MarcelKleiner/Puch/Zuendung/Bilder/IMG_3580.jpg

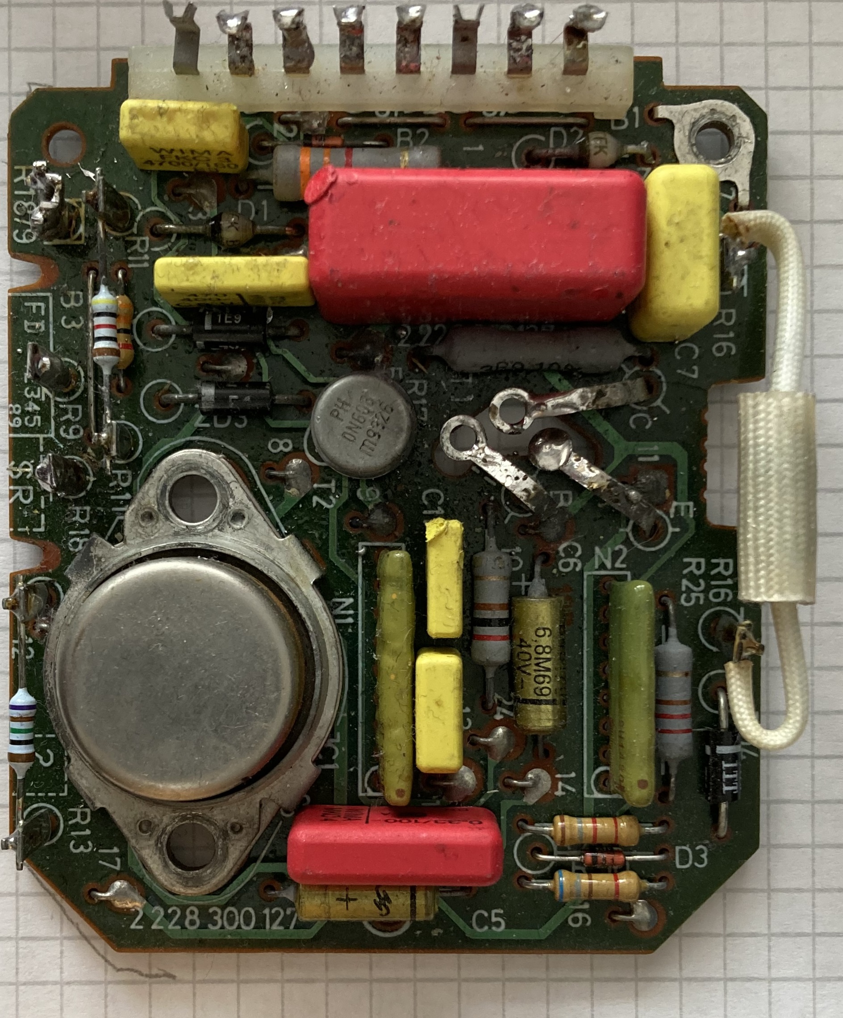
Zuendung/Bilder/IMG_3580.jpg
