MarcelKleiner/Puch/Zuendung/Bilder/PCB.docx

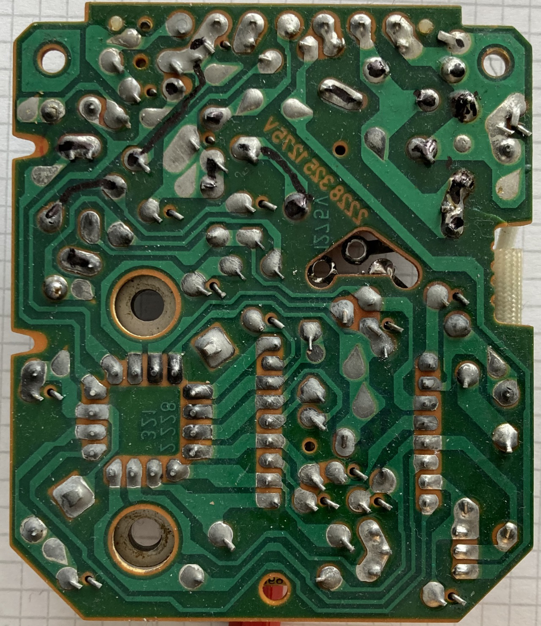
[picture p2: figure]
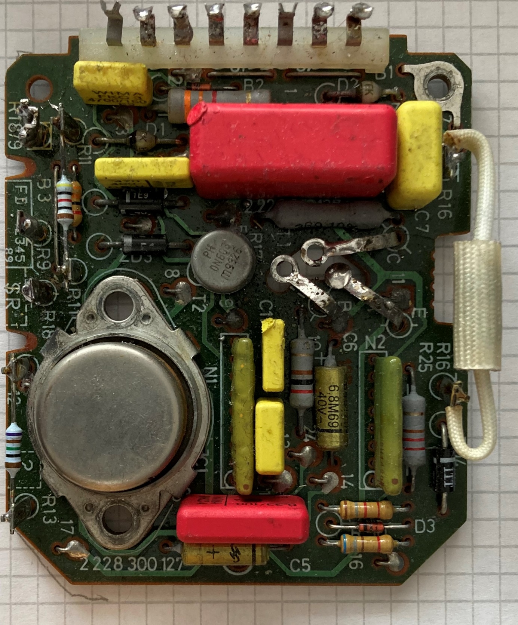
[picture p3: figure]
