MarcelKleiner/Puch/Zuendung/Software/IgnitionConfiguration/IgnitionConfiguration/Image2.png

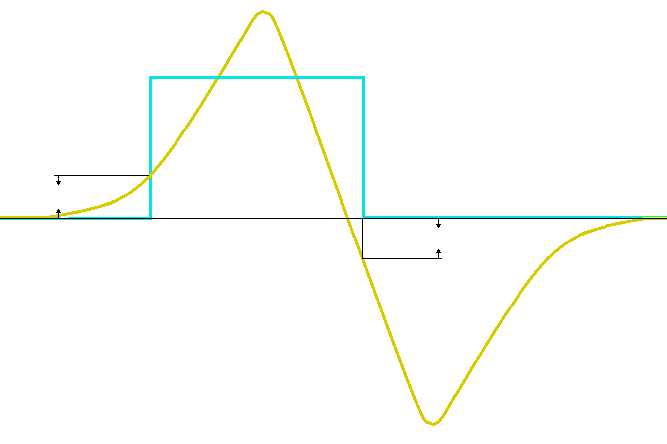
Zuendung/Software/IgnitionConfiguration/IgnitionConfiguration/Image2.png
