MarcelKleiner/Puch/Zuendung/Hardware/Zuendung/Schema.pdf

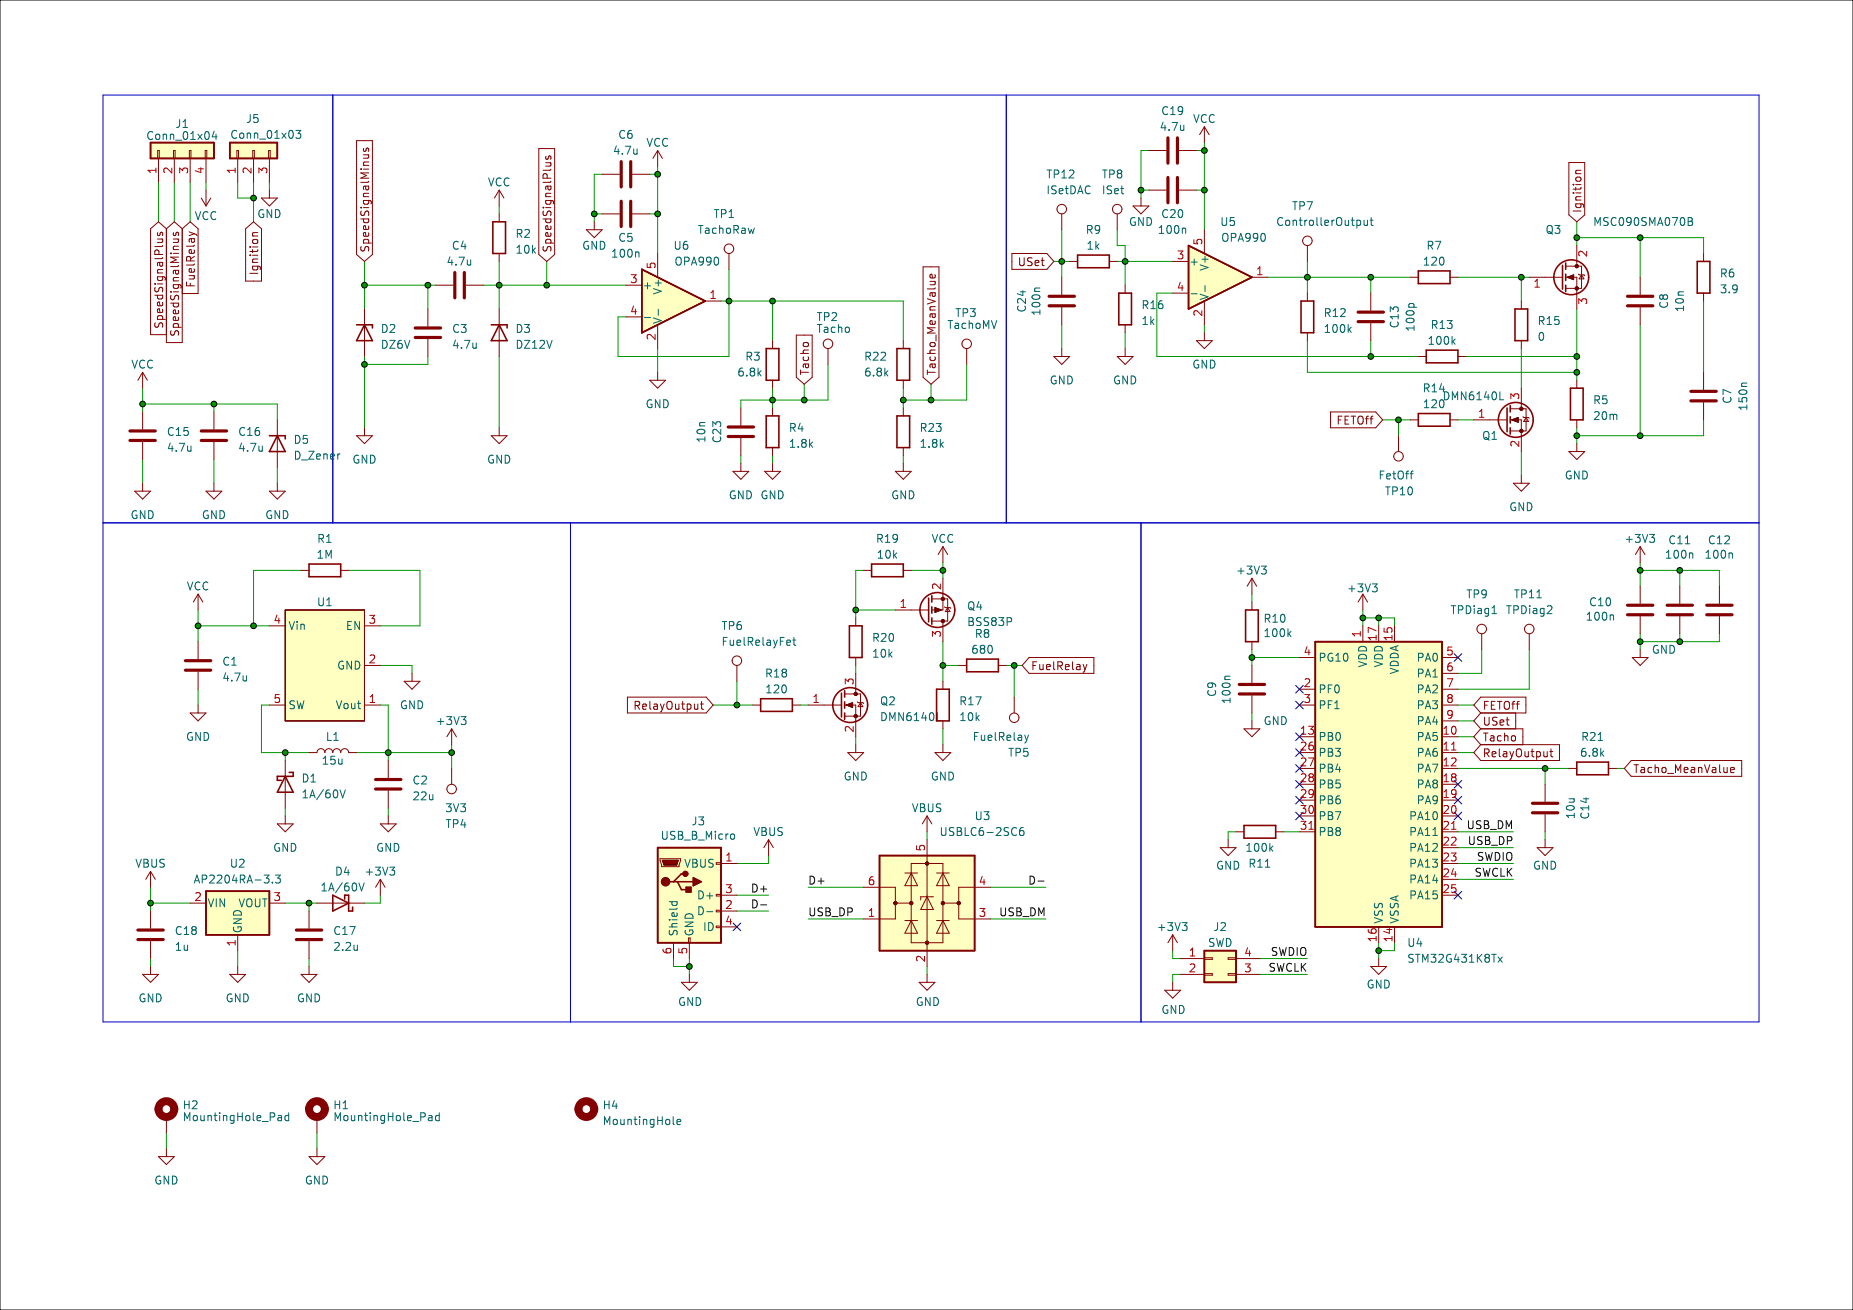
[picture p5: page 1]
