MarcelKleiner/Puch/Zuendung/Hardware/Zuendung/Zuendung.kicad_pcb

## KiCad design Zuendung/Hardware/Zuendung/Zuendung.kicad_pcb (2024-05-12)

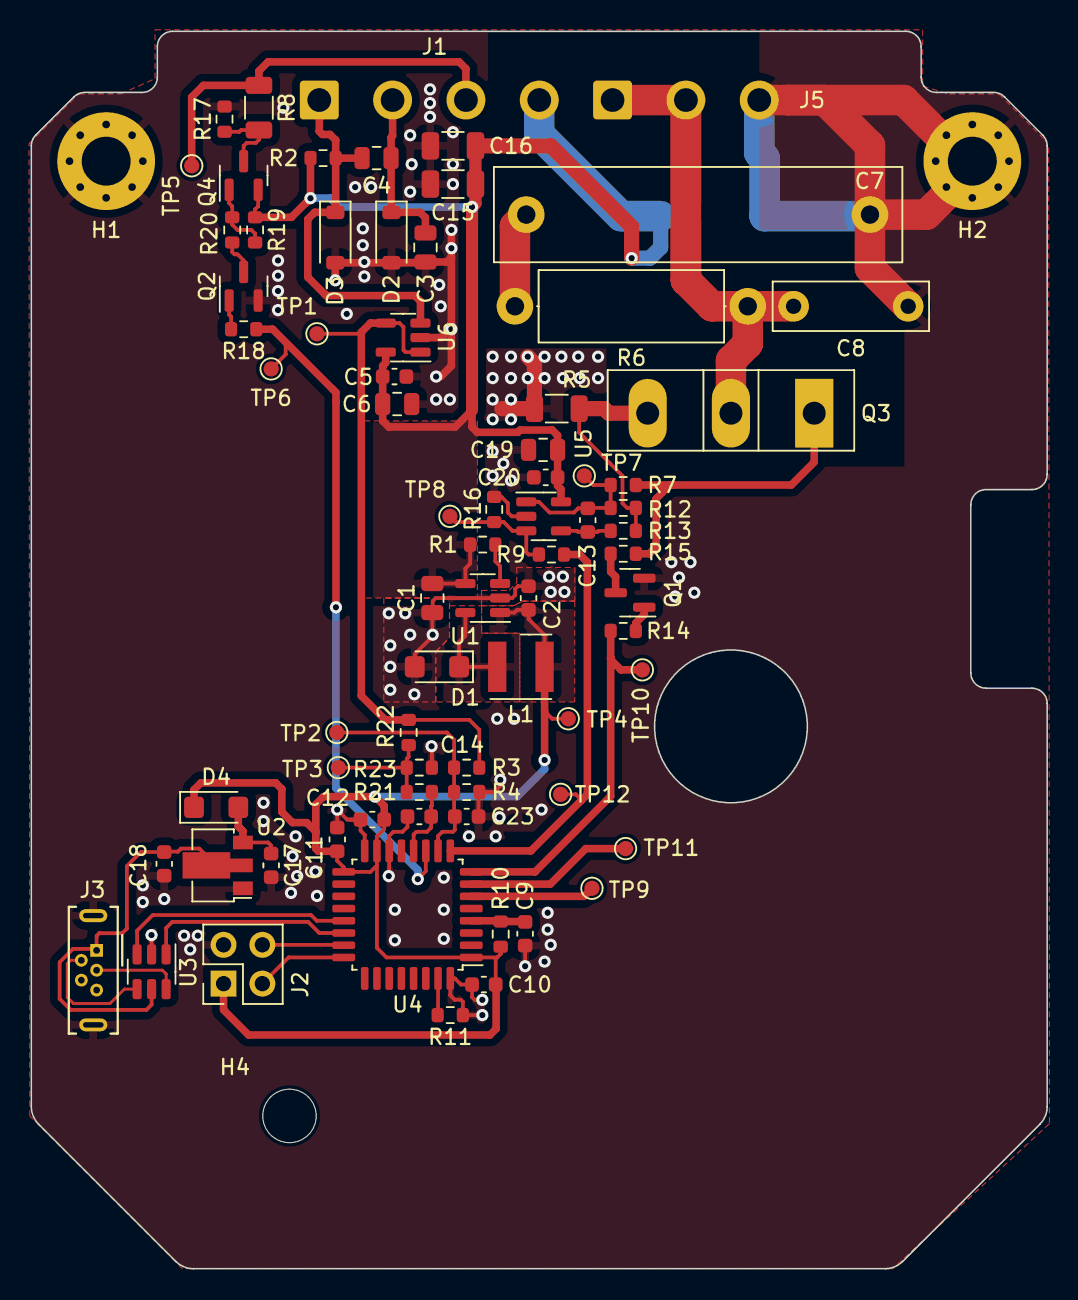
[picture p6: board Zuendung.kicad_pcb from above]

Board: 2 copper layers, 66.5 x 81.0 mm, 79 parts (1 on the bottom side), 40 nets.

Parts:
C1, C3, C4, C6, C19: 4.7u; C_0805_2012Metric
C2: 22u; C_0603_1608Metric
C5, C9, C10, C11, C12, C20: 100n; C_0603_1608Metric
C7: 150n; C_Rect_L26.5mm_W6.0mm_P22.50mm_MKS4
C8: 10n; C_Rect_L10.0mm_W3.0mm_P7.50mm_MKS4
C13: 100p; C_0603_1608Metric
C14: 10u; C_0603_1608Metric
C15, C16: 4.7u; C_1206_3216Metric
C17: 2.2u; C_0603_1608Metric
C18: 1u; C_0603_1608Metric
C23: 10n; C_0603_1608Metric
D1, D4: 1A/60V; D_SMF
D2: DZ6V; D_SOD-123
D3: DZ12V; D_SOD-123
D5: D_Zener; D_SMC
H1, H2: MountingHole_Pad; MountingHole_3.2mm_M3_Pad_Via
H4: MountingHole; MountingHole_3.5mm
J1: Conn_01x04; SolderWire-0.75sqmm_1x04_P4.8mm_D1.25mm_OD2.3mm
J2: SWD; PinHeader_2x02_P2.54mm_Vertical
J3: USB_B_Micro; USB_Micro-B_Wuerth_614105150721_Vertical
J5: Conn_01x03; SolderWire-0.75sqmm_1x03_P4.8mm_D1.25mm_OD2.3mm
L1: 15u; L_Wurth_WE-LQSH-4020
Q1, Q2: DMN6140L; SOT-23
Q3: MSC090SMA070B; TO-247-3_Vertical
Q4: BSS83P; SOT-23
R1: 1M; R_0603_1608Metric
R2, R17, R19, R20: 10k; R_0603_1608Metric
R3, R21, R22: 6.8k; R_0603_1608Metric
R4, R23: 1.8k; R_0603_1608Metric
R5: 20m; R_1206_3216Metric
R6: 3.9; R_Axial_DIN0414_L11.9mm_D4.5mm_P15.24mm_Horizontal
R7: 750; R_0603_1608Metric
R8: 680; R_1206_3216Metric
R9: 2.4k; R_0603_1608Metric
R10, R11, R12, R13: 100k; R_0603_1608Metric
R14, R18: 120; R_0603_1608Metric
R15: 0; R_0603_1608Metric
R16: 1; R_0603_1608Metric
TP1: TachoRaw; TestPoint_Pad_D1.0mm
TP2: Tacho; TestPoint_Pad_D1.0mm
TP3: TachoMV; TestPoint_Pad_D1.0mm
TP4: 3V3; TestPoint_Pad_D1.0mm
TP5: FuelRelay; TestPoint_Pad_D1.0mm
TP6: FuelRelayFet; TestPoint_Pad_D1.0mm
TP7: ControllerOutput; TestPoint_Pad_D1.0mm
TP8: ISet; TestPoint_Pad_D1.0mm
TP9: TPDiag1; TestPoint_Pad_D1.0mm
TP10: FetOff; TestPoint_Pad_D1.0mm
TP11: TPDiag2; TestPoint_Pad_D1.0mm
TP12: ISetDAC; TestPoint_Pad_D1.0mm
U1: SOT-23-5
U2: AP2204RA-3.3; SOT-89-3
U3: USBLC6-2SC6; SOT-23-6
U4: STM32G431K8Tx; LQFP-32_7x7mm_P0.8mm
U5, U6: OPA990; SOT-23-5

Connections:
+3V3: C2.1, C10.2, C11.2, C12.2, D4.1 (K), J2.1, L1.2, R10.1, TP4.1, U1.1 (Vout), U4.1 (VDD), U4.15 (VDDA), U4.17 (VDD)
/D+: J3.3 (D+), U3.6 (I/O1)
/D-: J3.2 (D-), U3.4 (I/O2)
/SWCLK: J2.3, U4.24 (PA14)
/SWDIO: J2.4, U4.23 (PA13)
/USB_DM: U3.3 (I/O2), U4.21 (PA11)
/USB_DP: U3.1 (I/O1), U4.22 (PA12)
FETOff: R14.1, TP10.1, U4.8 (PA3)
FuelRelay: J1.3, R8.1, TP5.1
GND: C1.2, C2.2, C3.2, C5.2, C6.2, C7.1, C8.1, C9.1, C10.1, C11.1, C12.1, C14.1, C15.2, C16.2, C17.2, C18.2, C19.2, C20.2, C23.1, D1.2 (A), D2.2 (A), D3.2 (A), D5.2 (A), H1.1, H2.1, J2.2, J3.5 (GND), J3.6 (Shield), J5.3, Q1.2 (S), Q2.2 (S), R4.2, R5.2, R11.1, R16.2, R17.2, R23.2, U1.2 (GND), U2.1 (GND), U3.2 (GND), U4.14 (VSSA), U4.16 (VSS), U4.32 (VSS), U5.2 (V-), U6.2 (V-)
Ignition: C8.2, J5.1, J5.2, Q3.2 (D), R6.1
unnamed: C7.2, R6.2
unnamed: C13.1, R7.1, R12.2, TP7.1, U5.1
unnamed: D1.1 (K), L1.1, U1.5 (SW)
unnamed: C17.1, D4.2 (A), U2.3 (VOUT)
unnamed: Q1.3 (D), R15.1
unnamed: Q1.1 (G), R14.2
unnamed: Q2.3 (D), R20.2
unnamed: Q2.1 (G), R18.2
unnamed: Q3.1 (G), R7.2, R15.2
unnamed: Q3.3 (S), R5.1, R12.1, R13.1
unnamed: Q4.3 (D), R8.2, R17.1
unnamed: Q4.1 (G), R19.2, R20.1
unnamed: R1.2, U1.3 (EN)
unnamed: TP9.1, U4.6 (PA1)
unnamed: TP11.1, U4.7 (PA2)
unnamed: C14.2, R21.2, U4.12 (PA7)
unnamed: R11.2, U4.31 (PB8)
unnamed: C9.2, R10.2, U4.4 (PG10)
unnamed: R9.1, R16.1, TP8.1, U5.3 (+)
unnamed: C13.2, R13.2, U5.4 (-)
unnamed: R3.1, R22.1, TP1.1, U6.1, U6.4 (-)
RelayOutput: R18.1, TP6.1, U4.11 (PA6)
SpeedSignalMinus: C3.1, C4.1, D2.1 (K), J1.2
SpeedSignalPlus: C4.2, D3.1 (K), J1.1, R2.2, U6.3 (+)
Tacho: C23.2, R3.2, R4.1, TP2.1, U4.10 (PA5)
Tacho_MeanValue: R21.1, R22.2, R23.1, TP3.1
USet: R9.2, TP12.1, U4.9 (PA4)
VBUS: C18.1, J3.1 (VBUS), U2.2 (VIN), U3.5 (VBUS)
VCC: C1.1, C5.1, C6.1, C15.1, C16.1, C19.1, C20.1, D5.1 (K), J1.4, Q4.2 (S), R1.1, R2.1, R19.1, U1.4 (Vin), U5.5 (V+), U6.5 (V+)
