MarcelKleiner/Puch/Zuendung/Hardware/Extension/Extension/Extension.kicad_pcb

## KiCad design Zuendung/Hardware/Extension/Extension/Extension.kicad_pcb (2024-04-23)

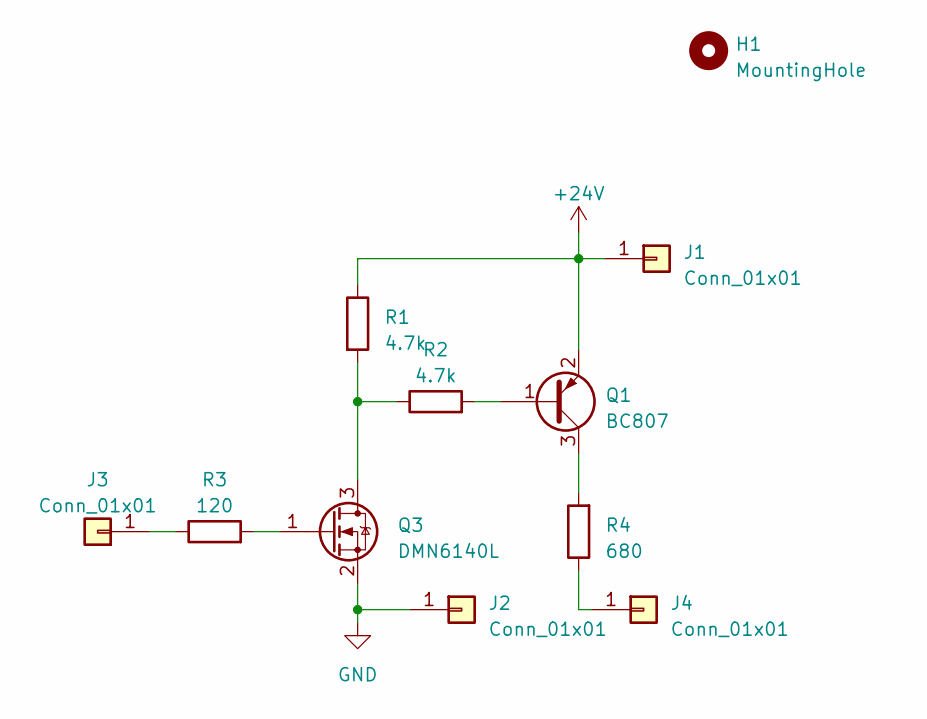
[picture p7: schematic Extension.kicad_sch]

Parts:
H1: MountingHole; MountingHole_3.2mm_M3
J1, J2, J3, J4: Conn_01x01; CONN_SMD
Q1: BC807; SOT-23
Q3: DMN6140L; SOT-23
R1, R2: 4.7k; R_1206_3216Metric
R3: 120; R_1206_3216Metric
R4: 680; R_1206_3216Metric

Connections:
+24V: J1.1, Q1.2 (E), R1.1
GND: J2.1, Q3.2 (S)
unnamed: J3.1, R3.1
unnamed: J4.1, R4.1
unnamed: Q1.1 (B), R2.2
unnamed: Q1.3 (C), R4.2
unnamed: Q3.3 (D), R1.2, R2.1
unnamed: Q3.1 (G), R3.2

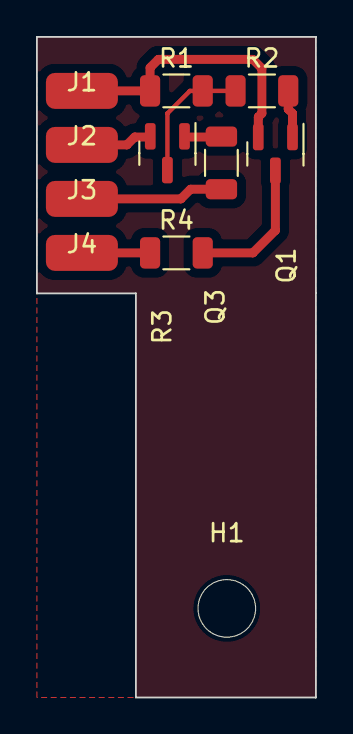
[picture p8: board Extension.kicad_pcb from above]

Board: 2 copper layers, 15.5 x 36.7 mm, 11 parts (0 on the bottom side), 8 nets.
