MarcelKleiner/Puch/Zuendung/Firmware/Ignition.ioc

Mcu.UserName=STM32G431K8Tx
PA11.Signal=USB_DM
PA12.Signal=USB_DP
PA13.Signal=SYS_JTMS-SWDIO
PA14.Signal=SYS_JTCK-SWCLK
PA3.GPIO_Label=IgnitionOff
PA3.Signal=GPIO_Output
PA4.GPIO_Label=ISet
PA4.Signal=COMP_DAC11_group
PA5.GPIO_Label=Tacho
PA5.Signal=ADC2_IN13
PA6.GPIO_Label=Relay
PA6.Signal=GPIO_Output
PA7.GPIO_Label=TachoMeanValue
PA7.Signal=ADC2_IN4
