MarcelKleiner/Puch/Zuendung/Firmware/Core/Inc/main.h

#define IgnitionOff_Pin GPIO_PIN_3
#define IgnitionOff_GPIO_Port GPIOA
#define ISet_Pin GPIO_PIN_4
#define ISet_GPIO_Port GPIOA
#define Tacho_Pin GPIO_PIN_5
#define Tacho_GPIO_Port GPIOA
#define Relay_Pin GPIO_PIN_6
#define Relay_GPIO_Port GPIOA
