MarcelKleiner/Puch/(commit log)

2024-04-06 Update HW
    [Zuendung.kicad_pcb, Zuendung.kicad_sch]
2024-04-15 Hardware finalized
    [Zuendung-B_Cu.gbr, Zuendung-B_Mask.gbr, Zuendung-B_Paste.gbr, Zuendung-B_Silkscreen.gbr, Zuendung-Edge_Cuts.gbr, Zuendung-F_Cu.gbr, Zuendung-F_Mask.gbr, Zuendung-F_Paste.gbr]
2024-04-23 Refactor project
    [Extension.kicad_pcb, Extension.kicad_sch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]
2024-05-01 Change foldername
    [Extension.kicad_pcb, Extension.kicad_sch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]
2024-05-09 changes for Version 2.0
    [Zuendung.kicad_sch]
2024-05-09 update Hardware
    [Zuendung.kicad_pcb, Zuendung.kicad_sch]
2024-05-12 udpdate Hardware
    [Zuendung.kicad_pcb, Zuendung.kicad_sch]
